ZhiangChen/flipping_robot/flipping_robot2/flipping_robot2_bb.pdf

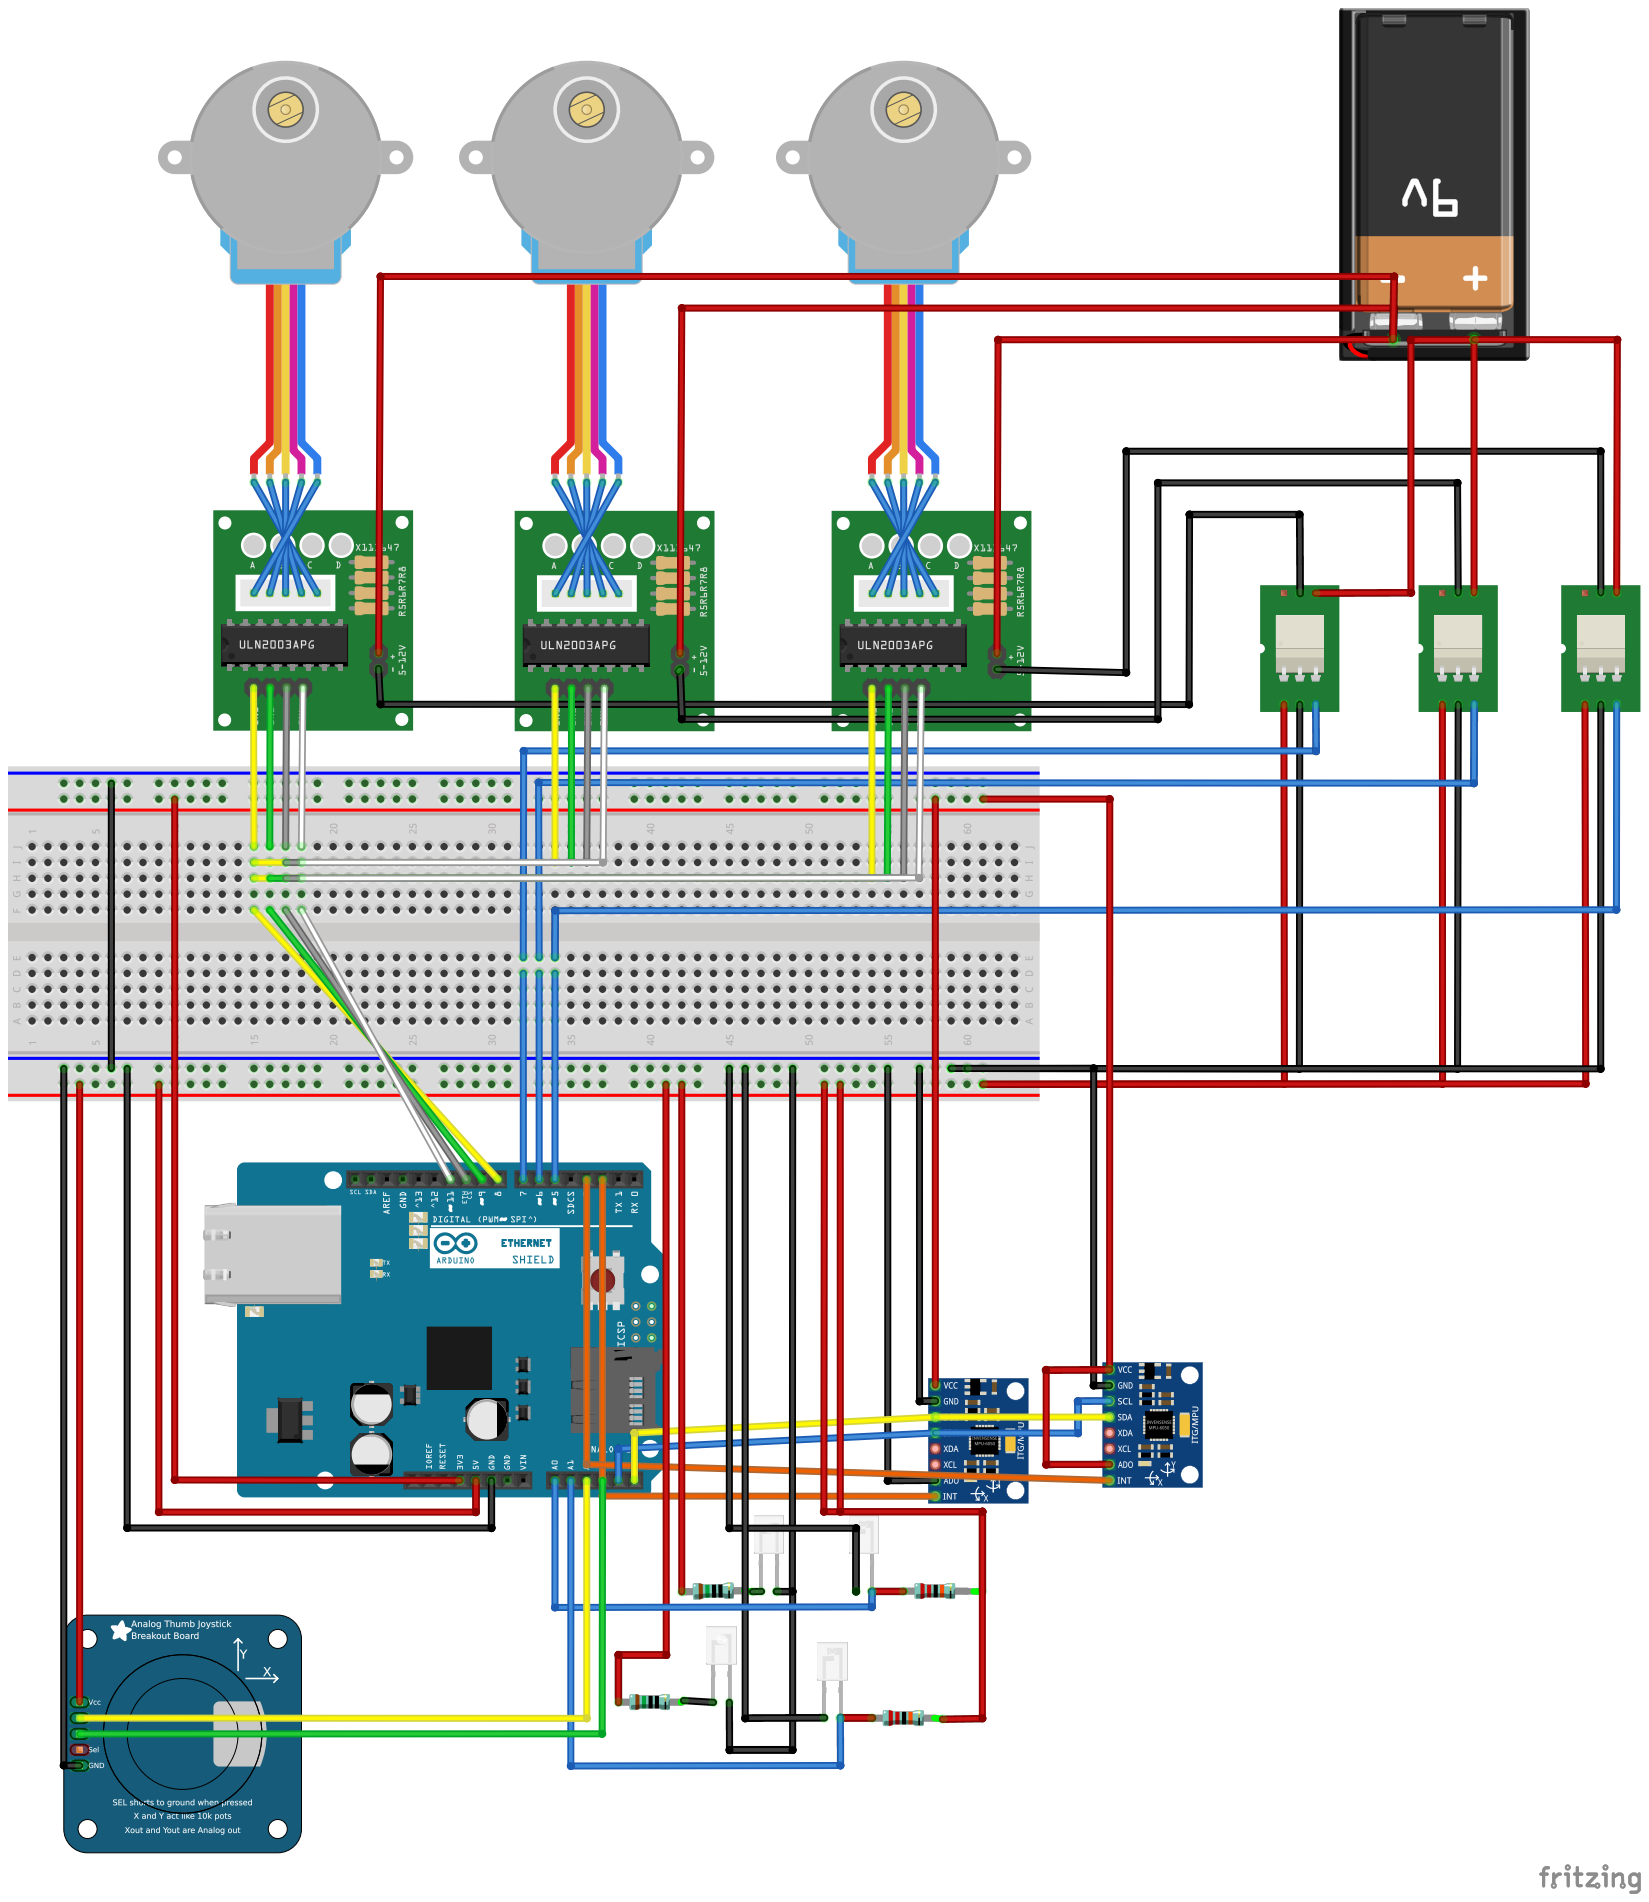
[picture p14: page 1]
